ee-lco/BenchBudEE/BenchBudEE.kicad_pcb

## KiCad design BenchBudEE.kicad_pcb (2014-04-20)

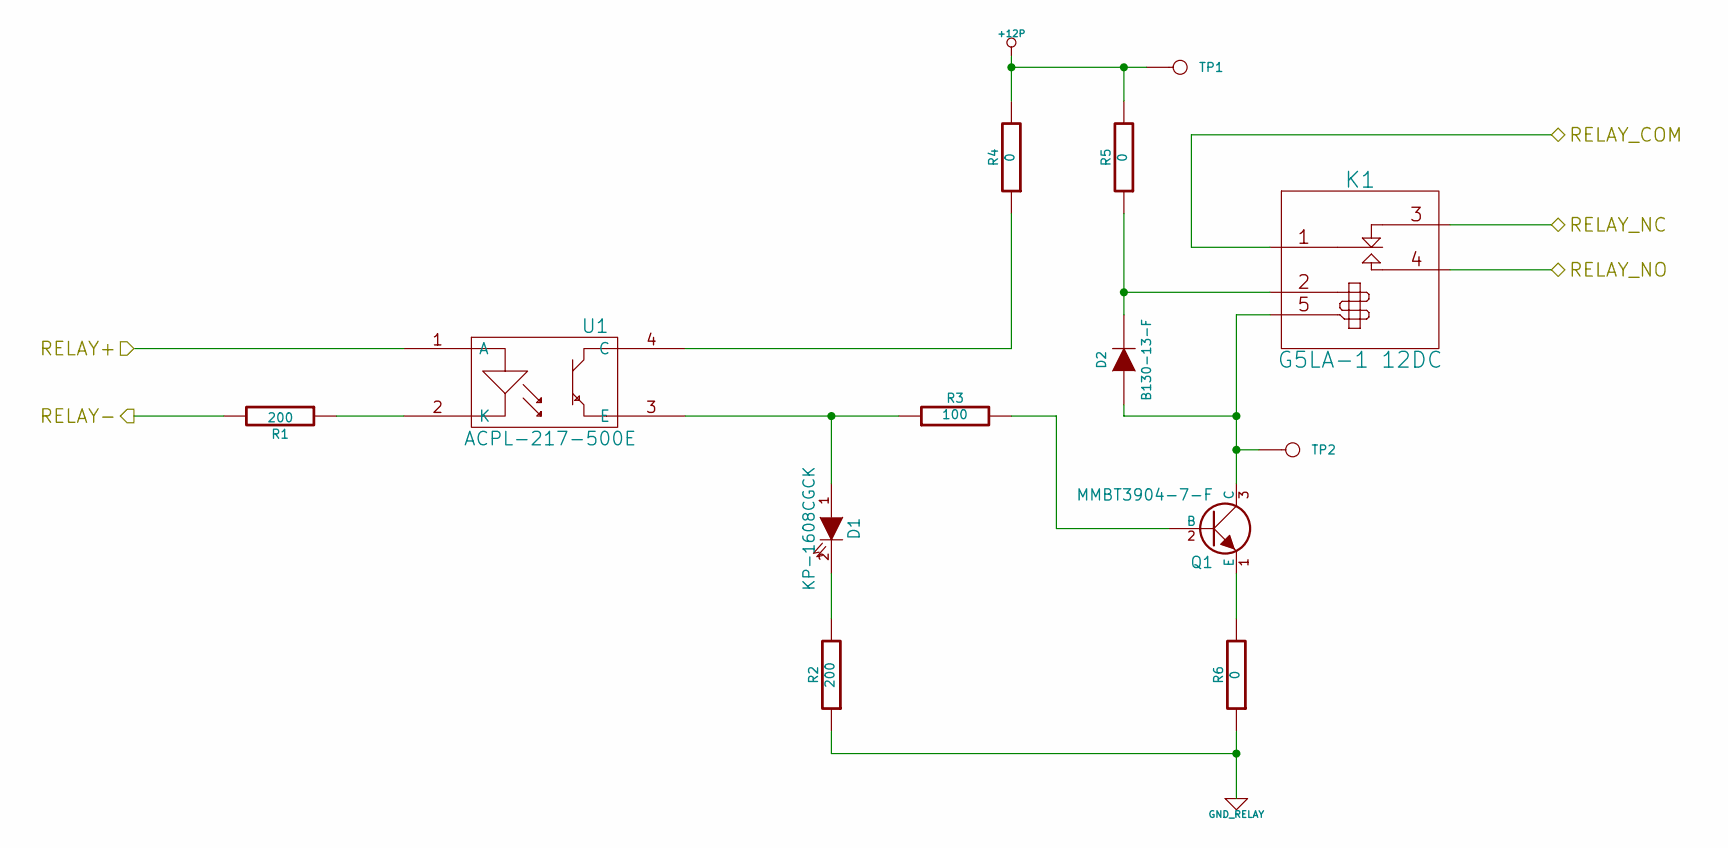
[picture p1: schematic Relay.sch]

Parts:
D1: KP-1608CGCK; LED-0603
D2: B130-13-F; Diode-SMA_Standard
K1: G5LA-1 12DC; TE-SPDT
Q1: MMBT3904-7-F; SOT23EBC; MFG Part Number MMBT3904-7-F
R1, R2: 200; SM0805
R3: 100; SM0805
R4, R5, R6: 0; SM0805
TP1: +12P; TestPointTH
TP2: RLY_LOW; TestPointTH
U1: ACPL-217-500E; 4-SMD; MFG Part Number LTV-816S

Connections:
+12P: R4.2, R5.2, TP1.1; also elsewhere on the board
/Arduino/RELAY+: U1.1 (A); also elsewhere on the board
/Arduino/RELAY-: R1.2; also elsewhere on the board
/Relay/RELAY_COM: K1.1 (COM); also elsewhere on the board
/Relay/RELAY_NC: K1.3 (NC); also elsewhere on the board
/Relay/RELAY_NO: K1.4 (NO); also elsewhere on the board
GND_RELAY: R2.1, R6.1; also elsewhere on the board
unnamed: D1.1 (A), R3.1, U1.3 (E)
unnamed: D1.2 (K), R2.2
unnamed: D2.1 (A), K1.5 (COIL-), Q1.3 (C), TP2.1
unnamed: D2.2 (K), K1.2 (COIL+), R5.1
unnamed: Q1.1 (E), R6.2
unnamed: Q1.2 (B), R3.2
unnamed: R1.1, U1.2 (K)
unnamed: R4.1, U1.4 (C)

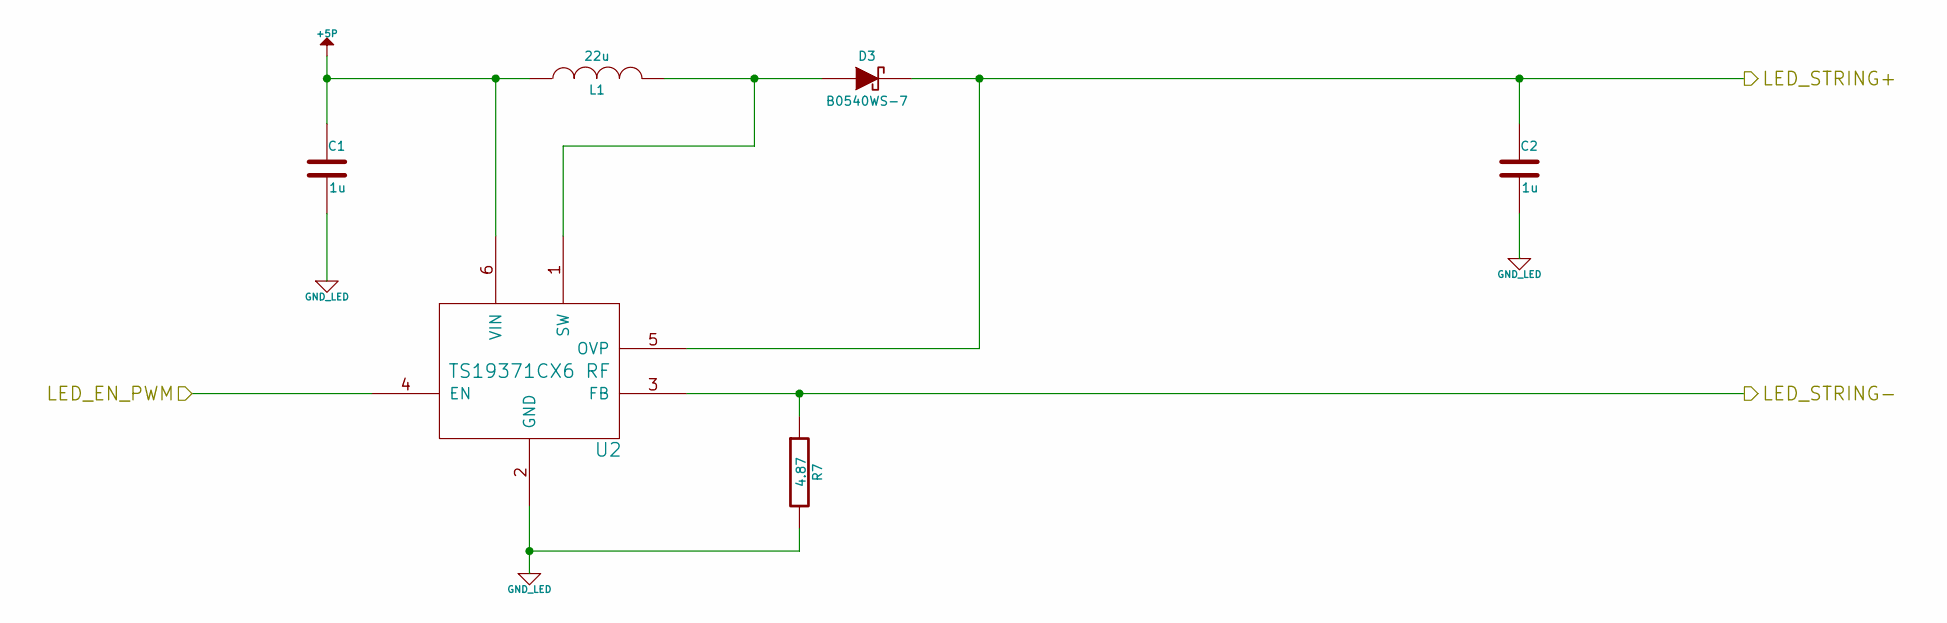
[picture p2: schematic LED_Driver.sch]

Parts:
C1, C2: 1u; c_0805
D3: B0540WS-7; SOD-323; MFG Part Number BO540WS-7
L1: 22u; NR4012; MFG Part Number NR4012T220M
R7: 4.87; SM0805
U2: TS19371CX6 RF; SOT23_6

Connections:
+5P: C1.1, L1.1, U2.6 (VIN); also elsewhere on the board
/Arduino/LED_EN_PWM: U2.4 (EN); also elsewhere on the board
/LED_Driver/LED_STRING+: C2.1, D3.2 (K), U2.5 (OVP); also elsewhere on the board
/LED_Driver/LED_STRING-: R7.1, U2.3 (FB); also elsewhere on the board
GND_LED: C1.2, C2.2, R7.2, U2.2 (GND); also elsewhere on the board
unnamed: D3.1 (A), L1.2, U2.1 (SW)

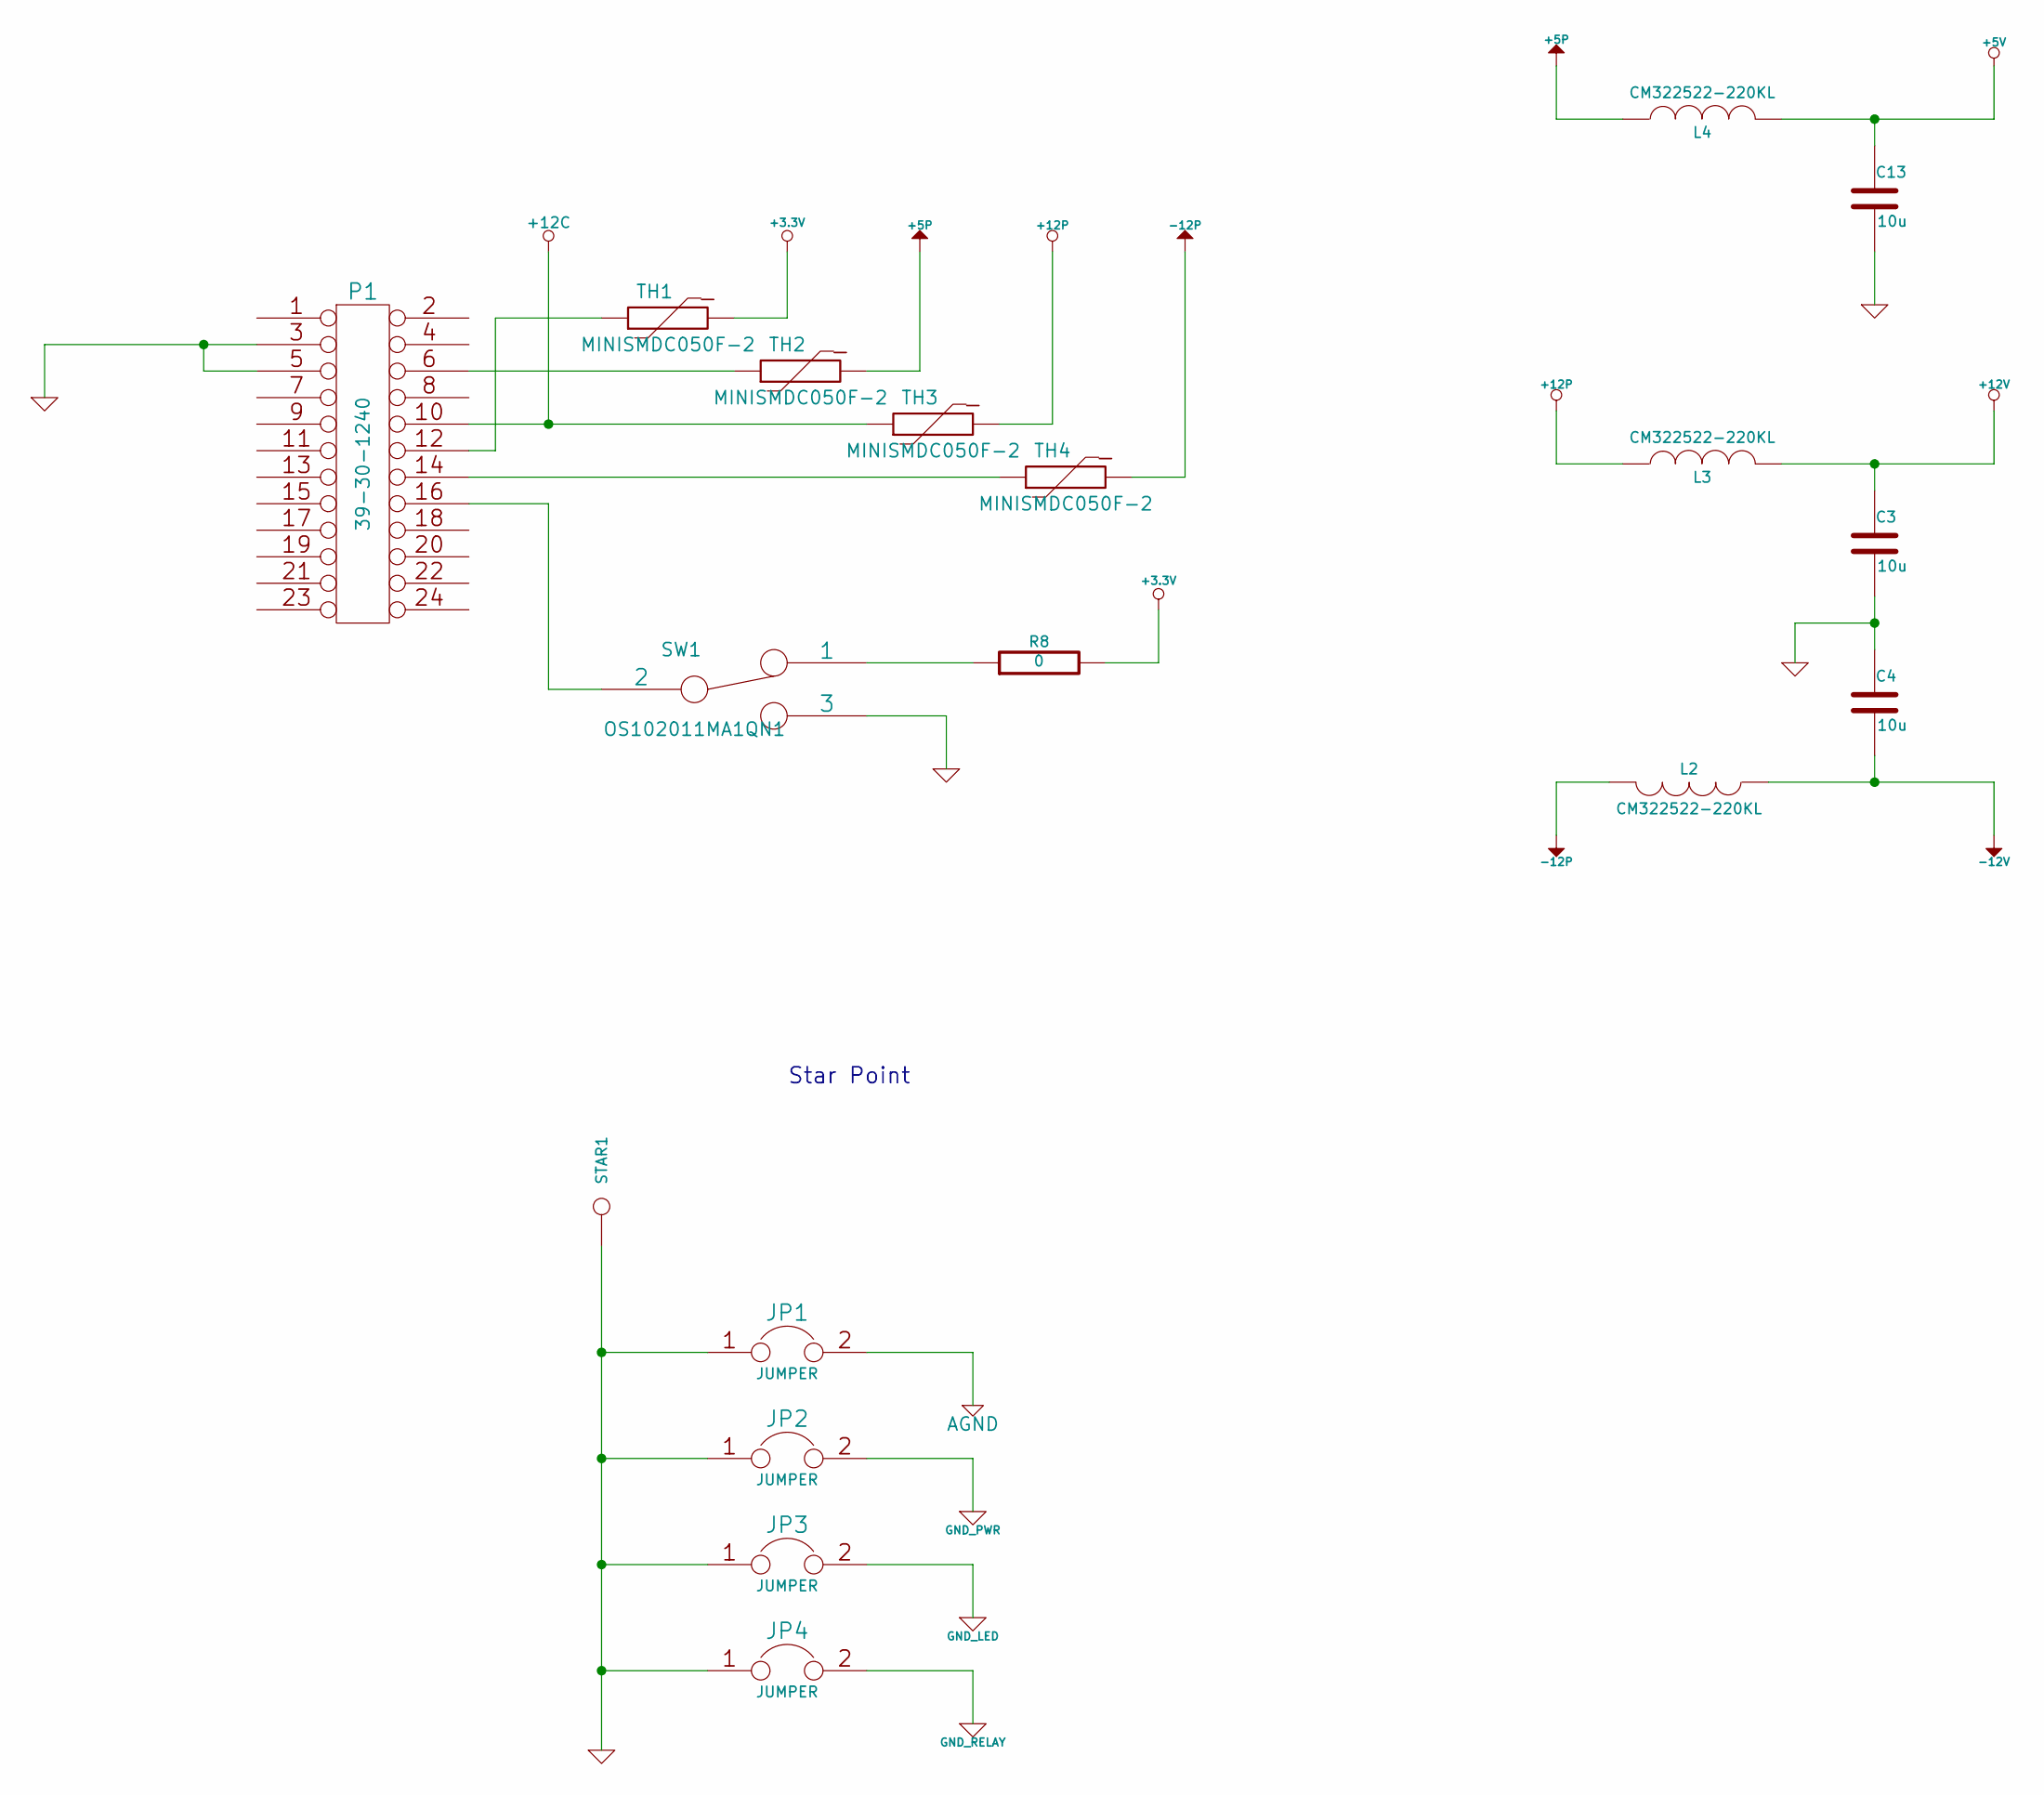
[picture p3: schematic Power.sch]

Parts:
C3, C4, C13: 10u; c_1206
JP1, JP2, JP3, JP4: JUMPER; GND_POINT
L2, L3, L4: CM322522-220KL; SM1210L
P1: 39-30-1240; ATX_Header; MFG Part Number 39-30-1240
R8: 0; SM0805
STAR1: CONN_1; 1pin
SW1: OS102011MA1QN1; BB_switch; MFG Part Number OS102011MA1QN1
TH1, TH2, TH3, TH4: MINISMDC050F-2; SM1812; MFG Part Number MINISMDC050F-2

Connections:
+3.3V: R8.2, TH1.2; also elsewhere on the board
+5P: L4.1, TH2.2; also elsewhere on the board
+5V: C13.1, L4.2; also elsewhere on the board
+12C: P1.10, TH3.1; also elsewhere on the board
+12P: L3.1, TH3.2; also elsewhere on the board
+12V: C3.1, L3.2; also elsewhere on the board
-12P: L2.2, TH4.2
-12V: C4.2, L2.1; also elsewhere on the board
AGND: JP1.2; also elsewhere on the board
GND: C3.2, C4.1, C13.2, JP1.1, JP2.1, JP3.1, JP4.1, P1.3, P1.5, STAR1.1, SW1.3; also elsewhere on the board
GND_LED: JP3.2; also elsewhere on the board
GND_PWR: JP2.2; also elsewhere on the board
GND_RELAY: JP4.2; also elsewhere on the board
unnamed: P1.6, TH2.1
unnamed: P1.12, TH1.1
unnamed: P1.14, TH4.1
unnamed: P1.16, SW1.2
unnamed: R8.1, SW1.1

Notes on the sheet:
Star Point

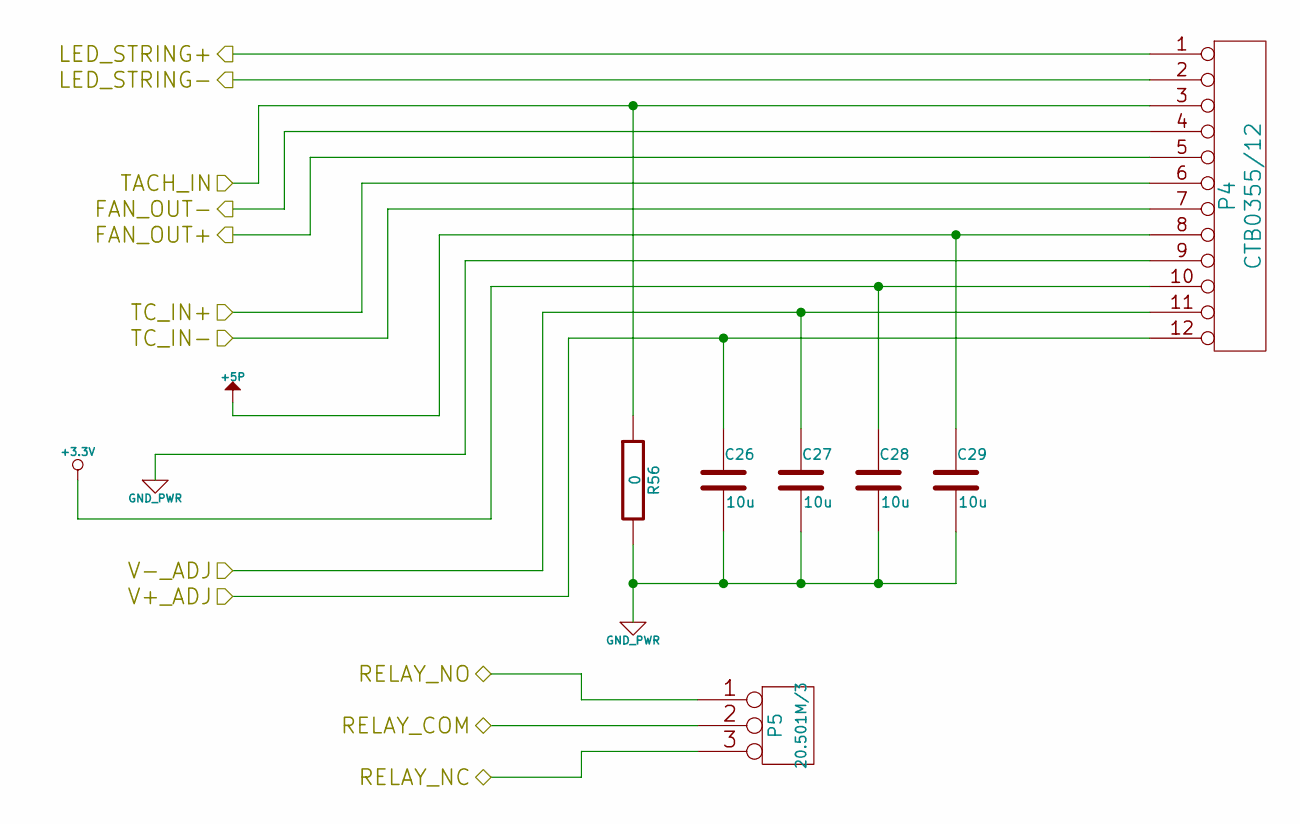
[picture p4: schematic TerminalBlock.sch]

Parts:
C26, C27, C28, C29: 10u; c_1210
P4: CTB0355/12; 12pinTB; MFG Part Number OSTTE120104
P5: 20.501M/3; 3pinTB; MFG Part Number 1935174
R56: 0; SM0805

Connections:
+3.3V: C28.1, P4.10; also elsewhere on the board
+5P: C29.1, P4.8; also elsewhere on the board
/Fan/FAN_OUT+: P4.5; also elsewhere on the board
/Fan/FAN_OUT-: P4.4; also elsewhere on the board
/Fan/TACH_IN: P4.3, R56.1; also elsewhere on the board
/LED_Driver/LED_STRING+: P4.1; also elsewhere on the board
/LED_Driver/LED_STRING-: P4.2; also elsewhere on the board
/PowerAdjustmentMonitor/V+_ADJ: C26.1, P4.12; also elsewhere on the board
/PowerAdjustmentMonitor/V-_ADJ: C27.1, P4.11; also elsewhere on the board
/Relay/RELAY_COM: P5.2 (PM); also elsewhere on the board
/Relay/RELAY_NC: P5.3; also elsewhere on the board
/Relay/RELAY_NO: P5.1; also elsewhere on the board
/TerminalBlock/TC_IN+: P4.6; also elsewhere on the board
/TerminalBlock/TC_IN-: P4.7; also elsewhere on the board
GND_PWR: C26.2, C27.2, C28.2, C29.2, P4.9, R56.2; also elsewhere on the board

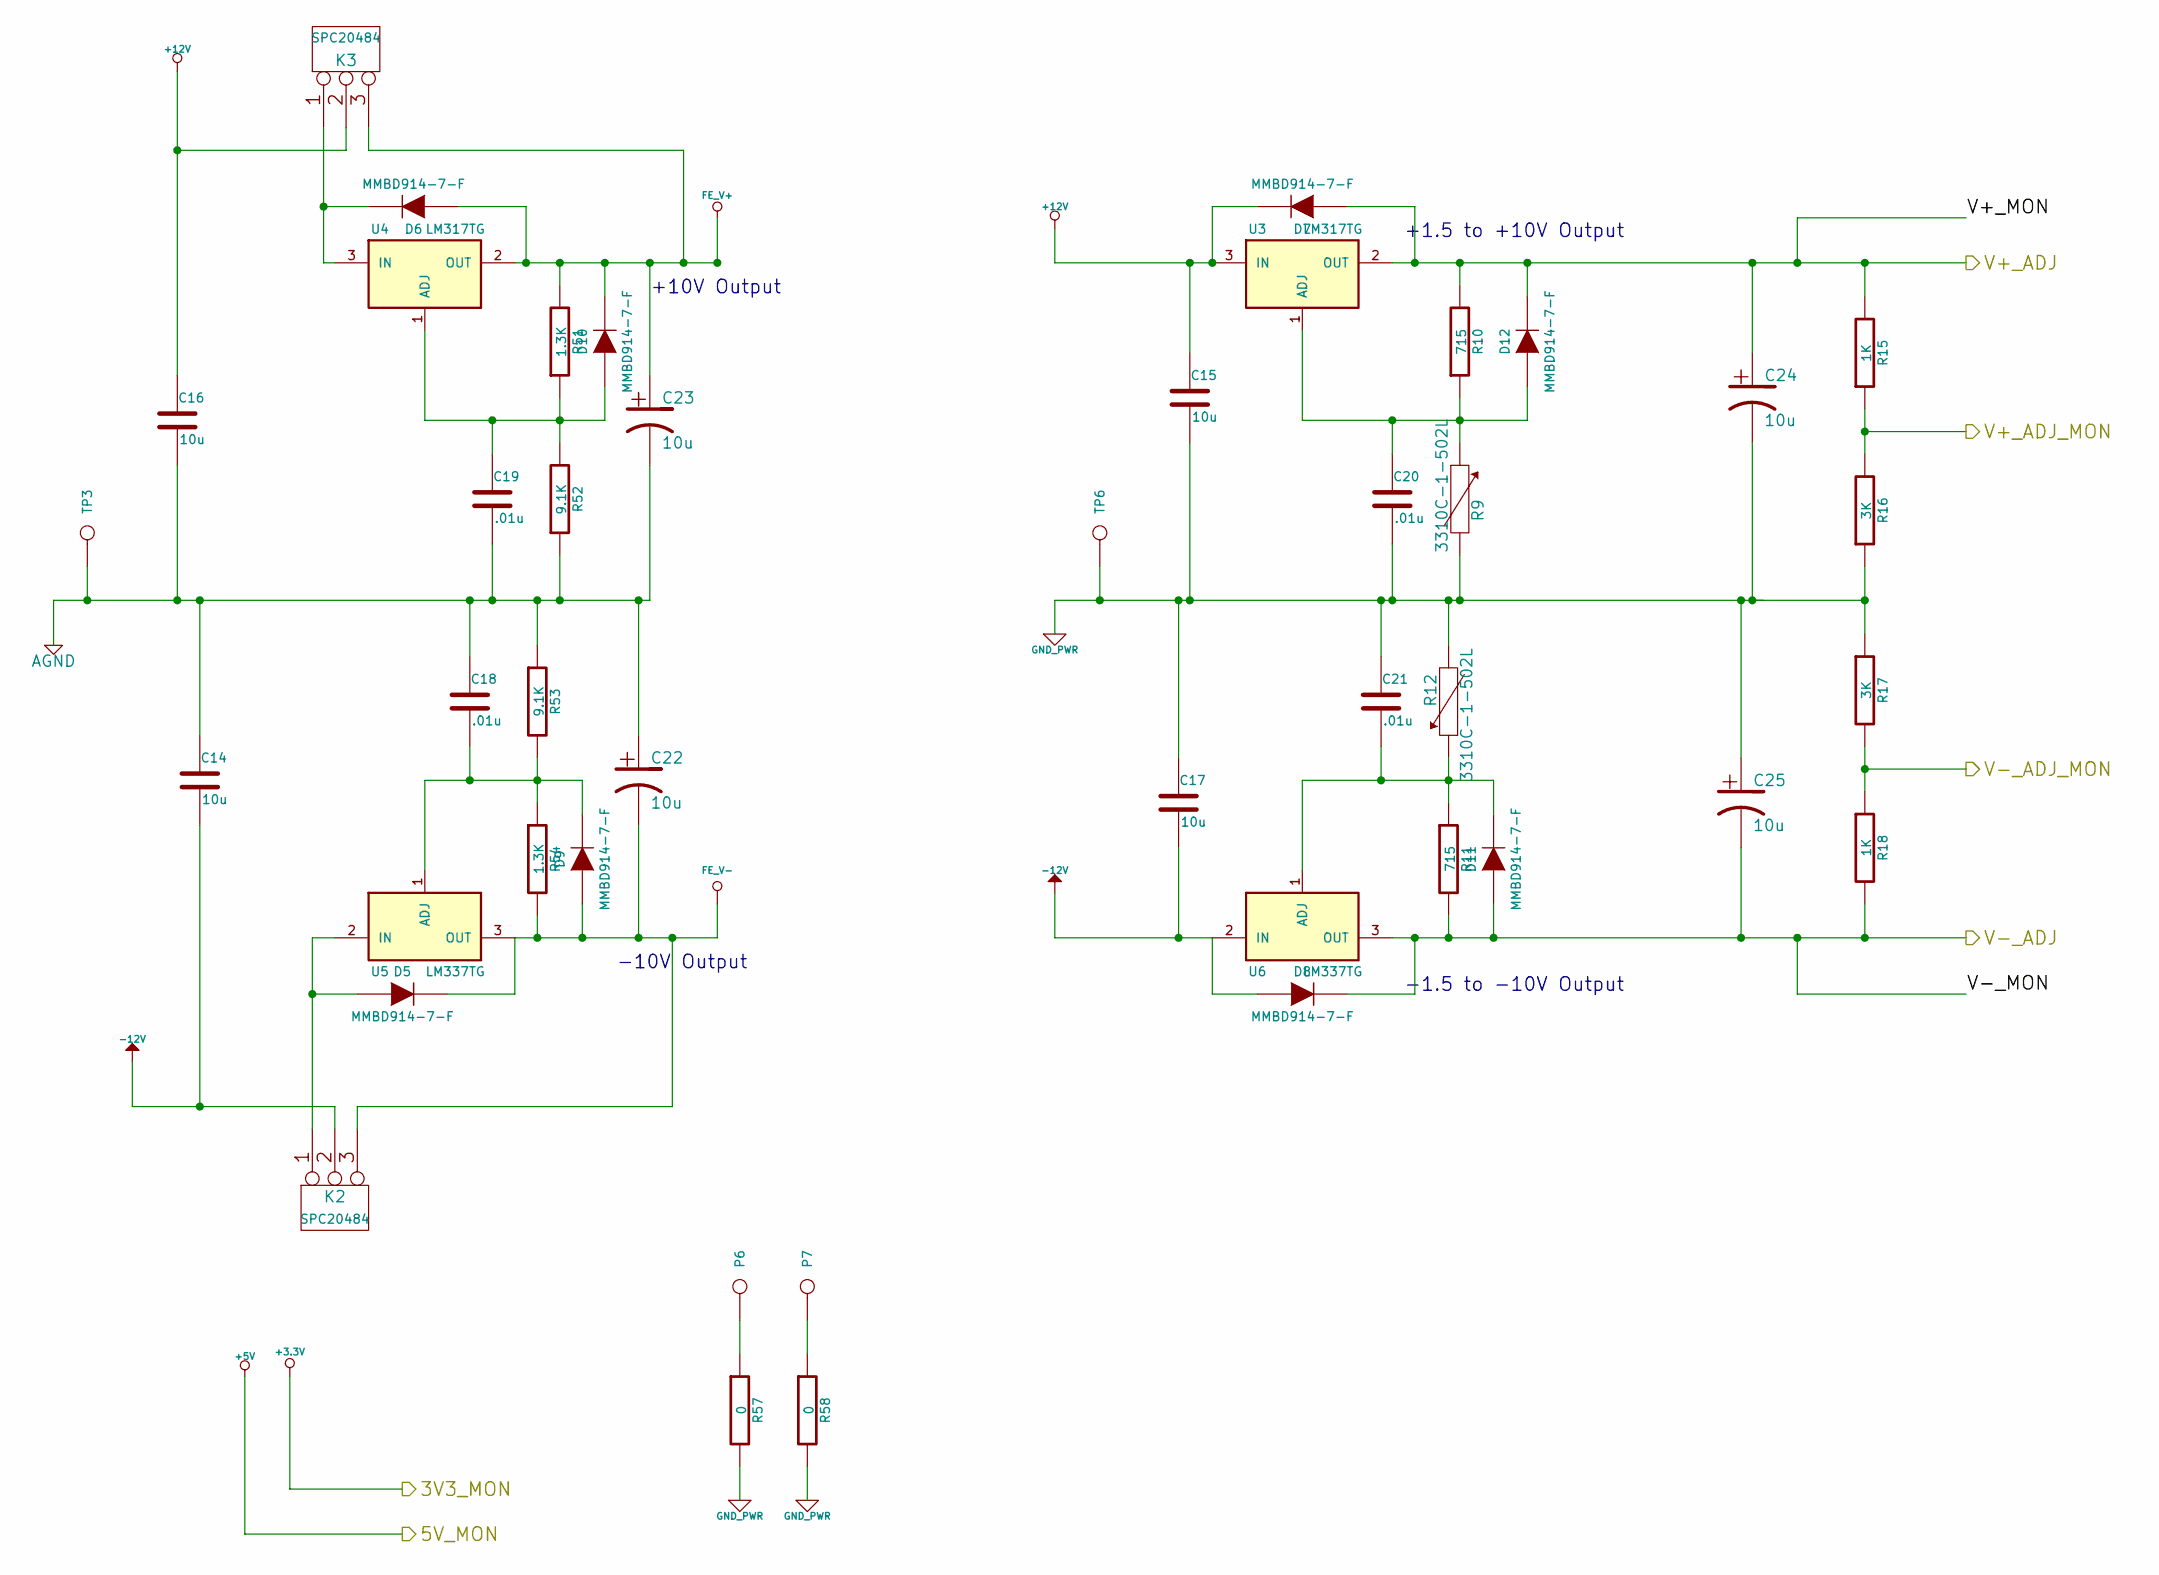
[picture p5: schematic PowerAdjustmentMonitor.sch]

Parts:
C14, C15, C16, C17, C22, C23, C24, C25: 10u; c_0805
C18, C19, C20, C21: .01u; c_0805
D5, D6, D7, D8, D9, D10, D11, D12: MMBD914-7-F; SOT23-DIODE; MFG Part Number MMBD914-7-F
K2, K3: SPC20484; Pin_Header_Straight_1x03
P6, P7: MC33282; V8508H
R9, R12: 3310C-1-502L; EVUE3K
R10, R11: 715; SM0805
R15, R18: 1K; SM0805
R16, R17: 3K; SM0805
R51, R54: 1.3K; SM0805
R52, R53: 9.1K; SM0805
R57, R58: 0; SM0805
TP3: AGND; TestPointTH
TP6: GND_PWR; TestPointTH
U3, U4: LM317TG; TO-220_Neutral123_Vertical
U5, U6: LM337TG; TO-220_Neutral123_Vertical

Connections:
+12V: C15.1, C16.1, D7.2 (K), K3.2 (PM), U3.3 (IN); also elsewhere on the board
-12V: C14.2, C17.2, D8.1 (A), K2.2 (PM), U6.2 (IN); also elsewhere on the board
/Arduino/V+_ADJ_MON: R15.1, R16.2; also elsewhere on the board
/Arduino/V-_ADJ_MON: R17.2, R18.1; also elsewhere on the board
/PowerAdjustmentMonitor/V+_ADJ: C24.1, D7.1 (A), D12.2 (K), R10.2, R15.2, U3.2 (OUT); also elsewhere on the board
/PowerAdjustmentMonitor/V-_ADJ: C25.2, D8.2 (K), D11.1 (A), R11.2, R18.2, U6.3 (OUT); also elsewhere on the board
AGND: C14.1, C16.2, C18.1, C19.2, C22.1, C23.2, R52.1, R53.1, TP3.1; also elsewhere on the board
FE_V+: C23.1, D6.1 (A), D10.2 (K), K3.3, R51.2, U4.2 (OUT); also elsewhere on the board
FE_V-: C22.2, D5.2 (K), D9.1 (A), K2.3, R54.2, U5.3 (OUT); also elsewhere on the board
GND_PWR: C15.2, C17.1, C20.2, C21.1, C24.2, C25.1, R9.2, R12.2, R16.1, R17.1, R57.2, R58.2, TP6.1; also elsewhere on the board
unnamed: C18.2, D9.2 (K), R53.2, R54.1, U5.1 (ADJ)
unnamed: C19.1, D10.1 (A), R51.1, R52.2, U4.1 (ADJ)
unnamed: C20.1, D12.1 (A), R9.1, R10.1, U3.1 (ADJ)
unnamed: C21.2, D11.2 (K), R11.1, R12.1, U6.1 (ADJ)
unnamed: D5.1 (A), K2.1, U5.2 (IN)
unnamed: D6.2 (K), K3.1, U4.3 (IN)
unnamed: P6.1, R57.1
unnamed: P7.1, R58.1

Notes on the sheet:
+10V Output
+1.5 to +10V Output
-1.5 to -10V Output
-10V Output

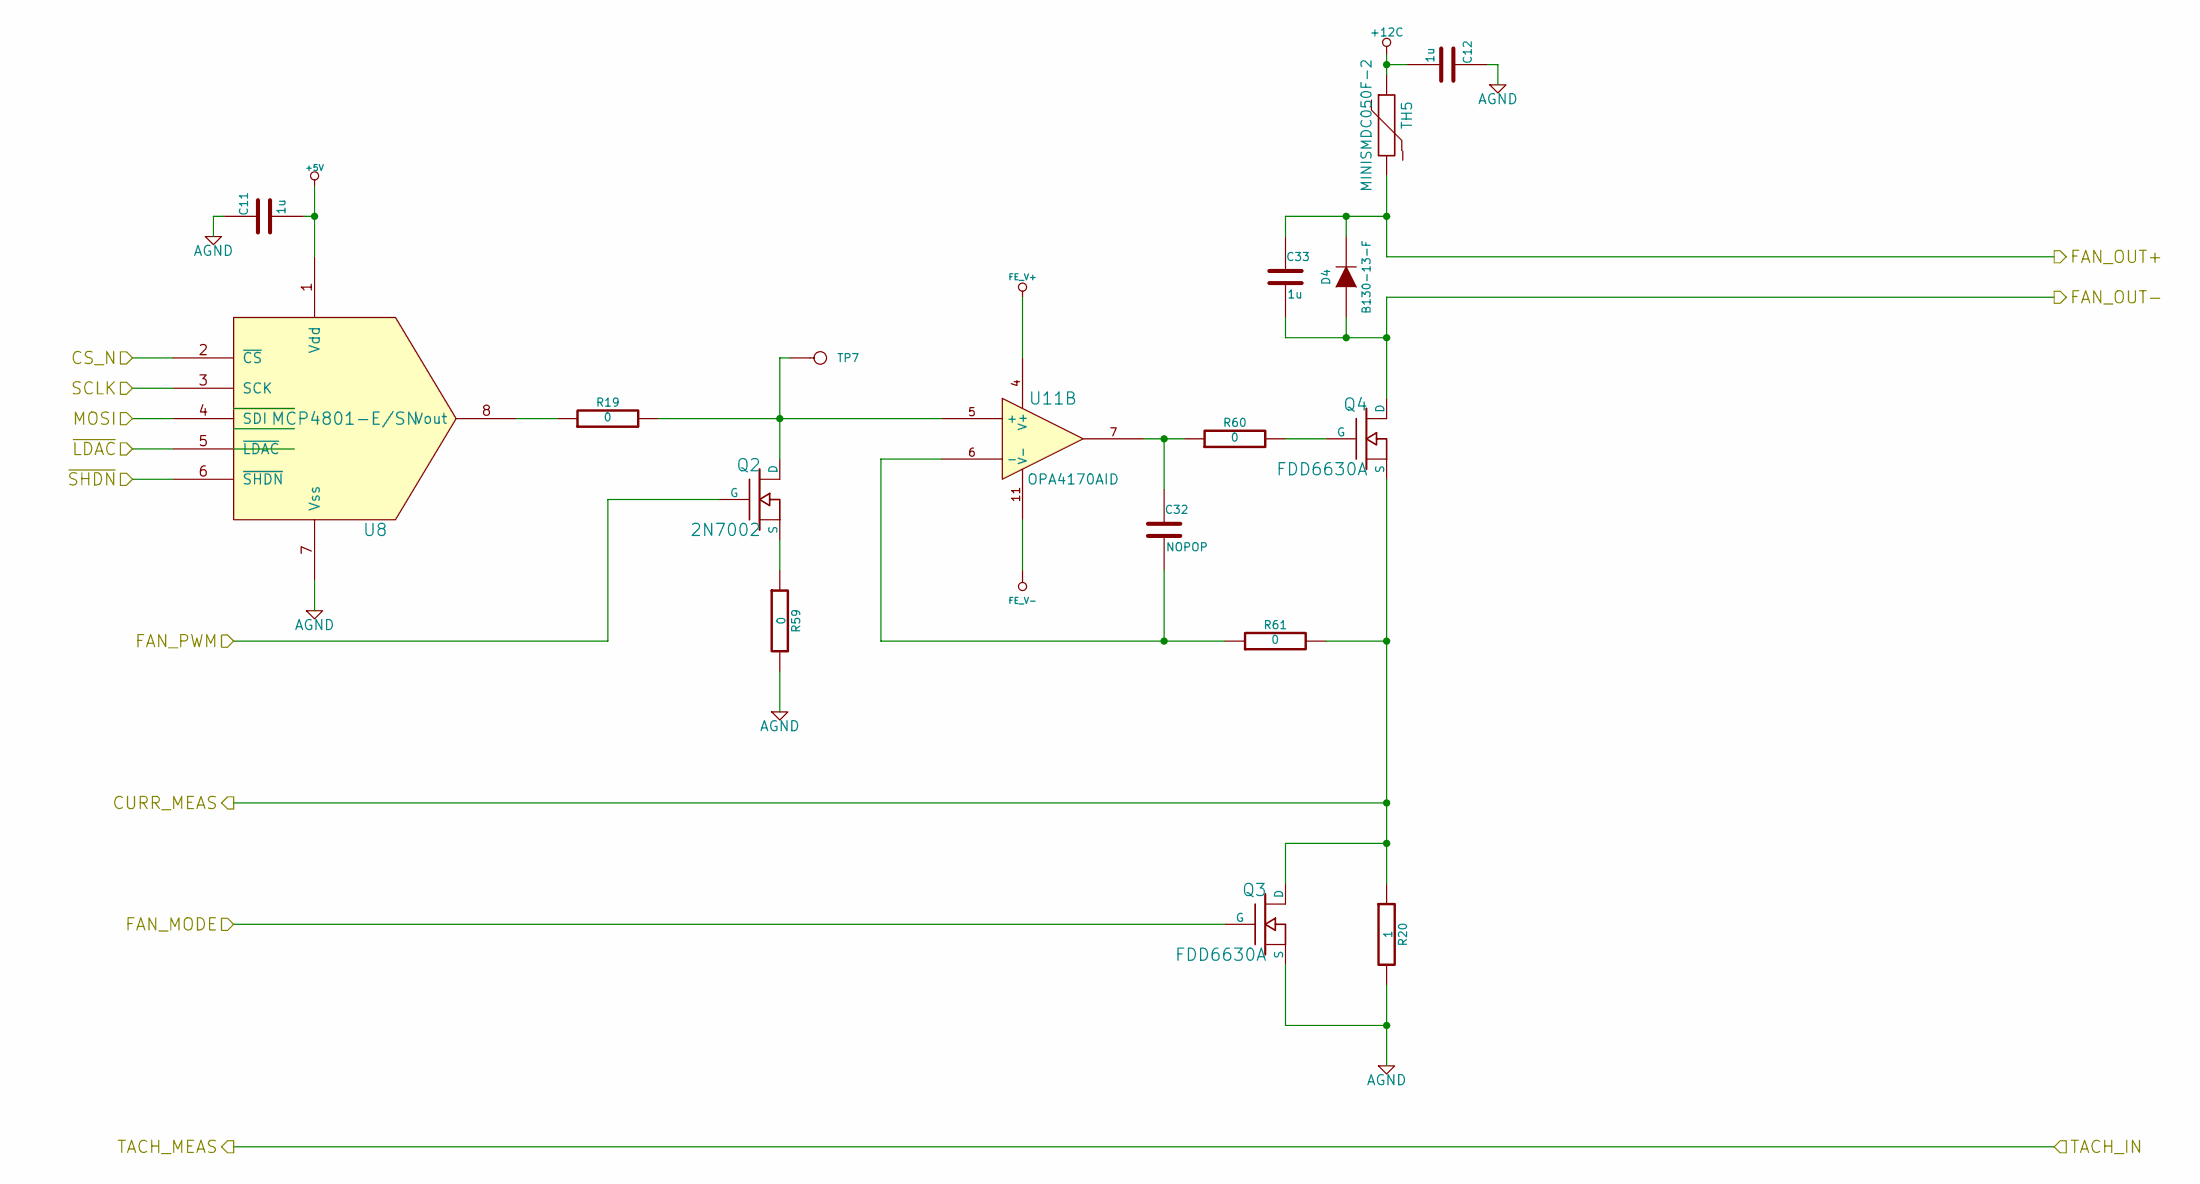
[picture p6: schematic Fan.sch]

Parts:
C11, C12, C33: 1u; c_0805
C32: NOPOP; c_0805
D4: B130-13-F; Diode-SMA_Standard; MFG Part Number B130-13-F
Q2: 2N7002; SOT23EBC; MFG Part Number DMN65D8L-7
Q3, Q4: FDD6630A; DPAK2; MFG Part Number AOD476
R19, R59, R60, R61: 0; SM0805
R20: 1; SM1206
TH5: MINISMDC050F-2; SM1812; MFG Part Number MINISMDC050F-2
TP7: DAC_OUT; TestPointTH
U8: MCP4801-E/SN; SO8N
U11: OPA4170AID; SO14E

Connections:
+5V: C11.2, U8.1 (Vdd); also elsewhere on the board
+12C: C12.2, TH5.1; also elsewhere on the board
/Arduino/CURR_MEAS: Q3.2 (D), Q4.3 (S), R20.1, R61.2; also elsewhere on the board
/Arduino/FAN_MODE: Q3.1 (G); also elsewhere on the board
/Arduino/FAN_PWM: Q2.1 (G); also elsewhere on the board
/Arduino/MOSI: U8.4 (SDI); also elsewhere on the board
/Arduino/SCLK: U8.3 (SCK); also elsewhere on the board
/Arduino/~LDAC: U8.5 (~LDAC); also elsewhere on the board
/Arduino/~SHDN: U8.6 (~SHDN); also elsewhere on the board
/Fan/CS_N: U8.2 (~CS); also elsewhere on the board
/Fan/FAN_OUT+: C33.1, D4.2 (K), TH5.2; also elsewhere on the board
/Fan/FAN_OUT-: C33.2, D4.1 (A), Q4.2 (D); also elsewhere on the board
AGND: C11.1, C12.1, Q3.3 (S), R20.2, R59.2, U8.7 (Vss); also elsewhere on the board
FE_V+: U11.4 (V+); also elsewhere on the board
FE_V-: U11.11 (V-); also elsewhere on the board
unnamed: C32.1, R60.1, U11.7
unnamed: C32.2, R61.1, U11.6 (-)
unnamed: Q2.2 (D), R19.2, TP7.1, U11.5 (+)
unnamed: Q2.3 (S), R59.1
unnamed: Q4.1 (G), R60.2
unnamed: R19.1, U8.8 (Vout)

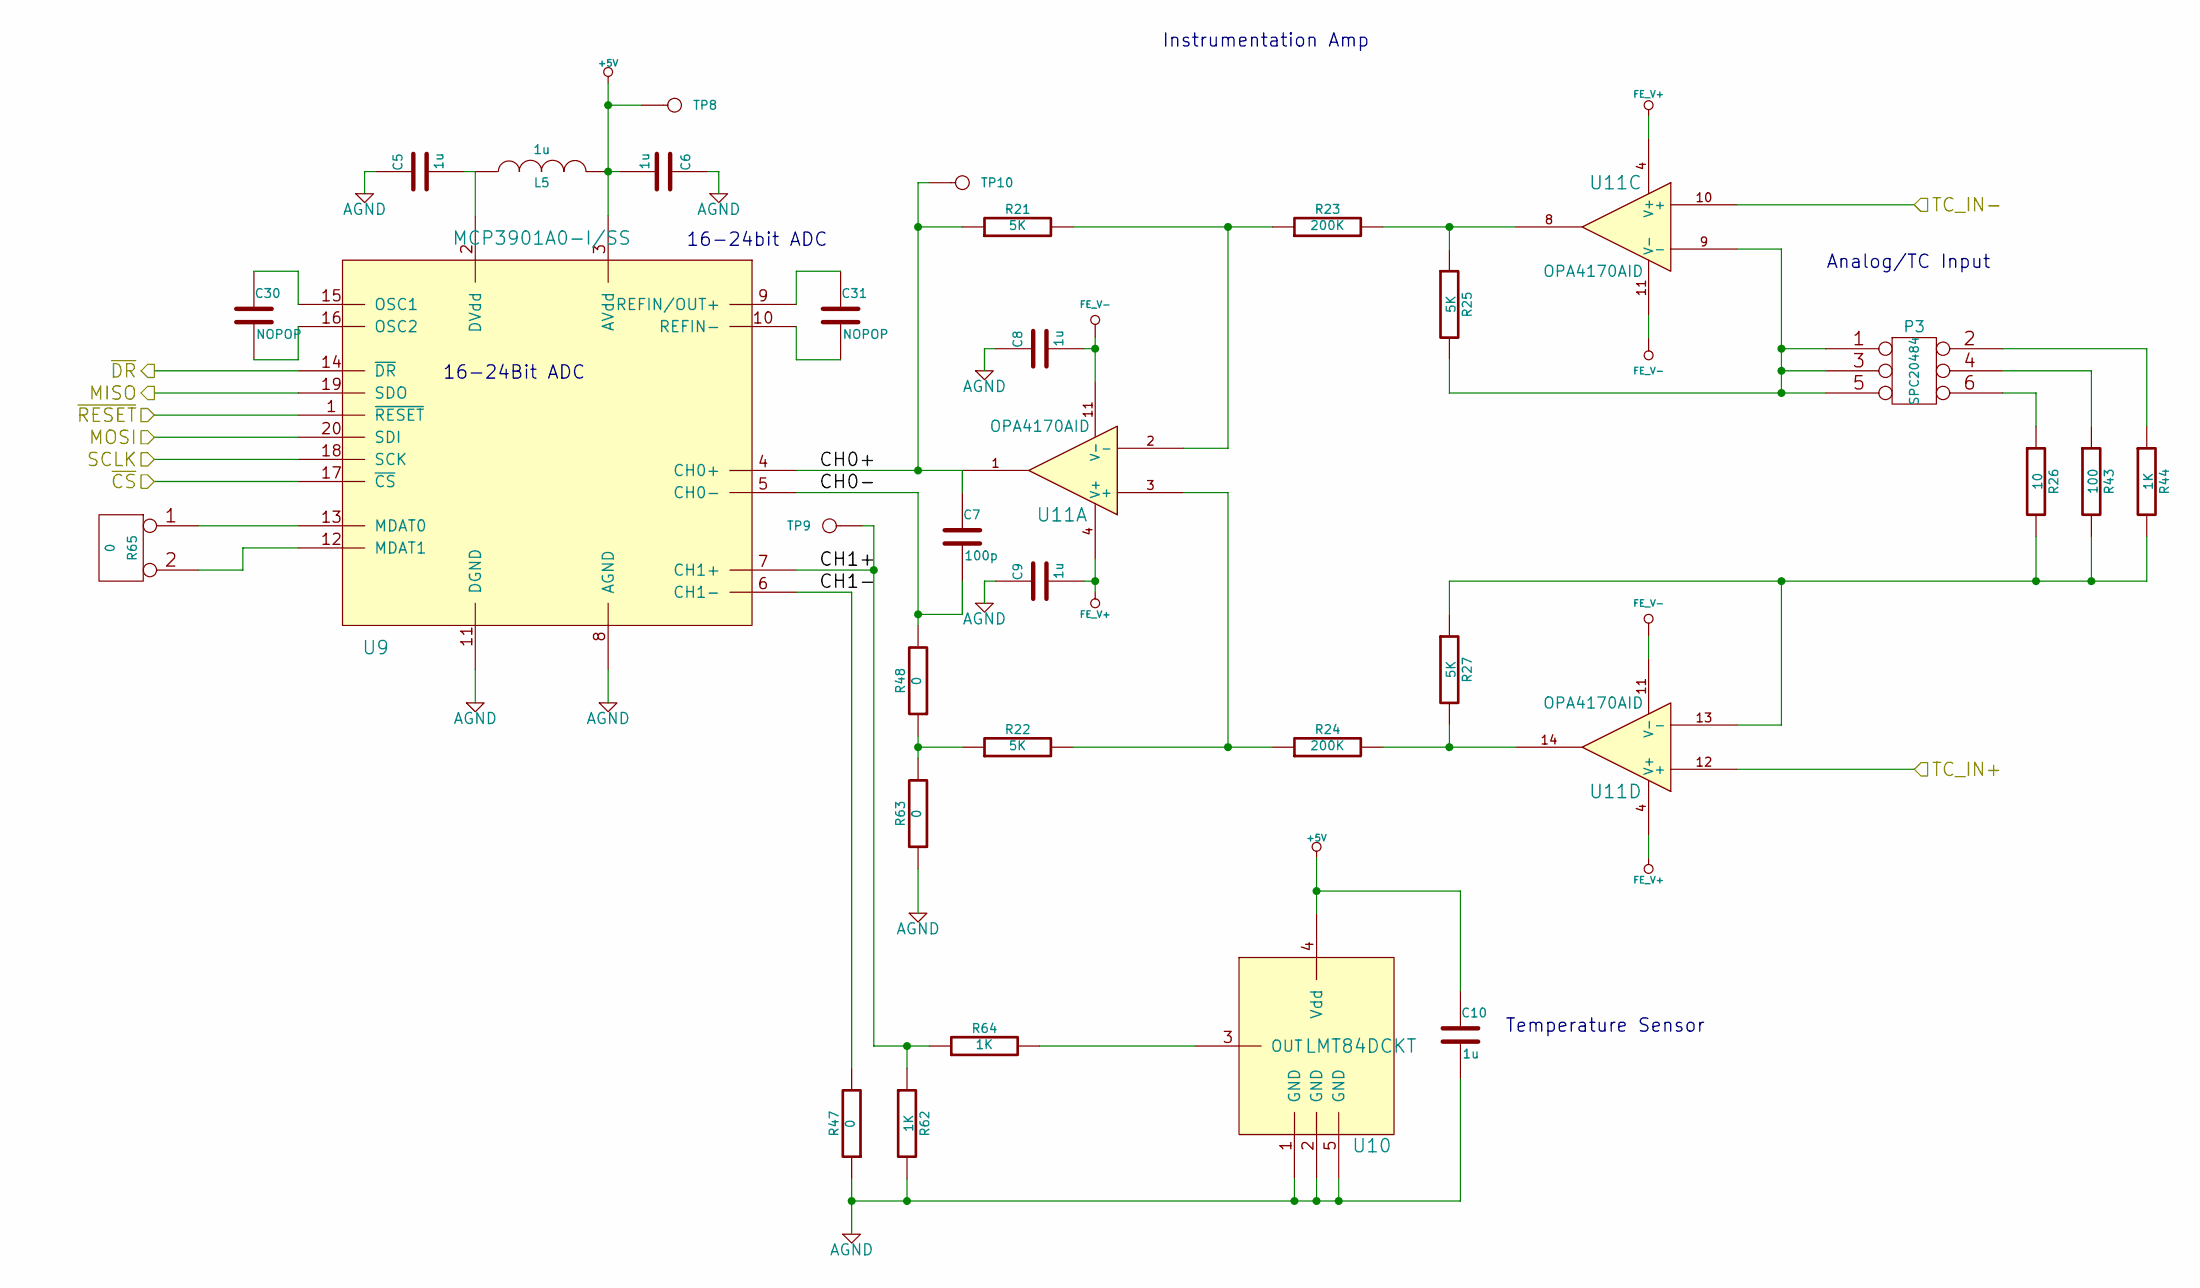
[picture p7: schematic Thermocouple.sch]

Parts:
C5, C6, C8, C9, C10: 1u; c_0805
C7: 100p; c_0805
C30, C31: NOPOP; c_0805
L5: 1u; SM0805
P3: SPC20484; Pin_Header_Straight_2x03
R21, R22: 5K; SM1206
R23, R24: 200K; SM1206
R25, R27: 5K; SM0805
R26: 10; SM0805
R43: 100; SM0805
R44, R62, R64: 1K; SM0805
R47, R48, R63, R65: 0; SM0805
TP8: +5V; TestPointTH
TP9: CH1+; TestPointTH
TP10: CH0+; TestPointTH
U9: MCP3901A0-I/SS; SSOP20
U10: LMT84DCKT; SOT353
U11: OPA4170AID; SO14E

Connections:
+5V: C6.2, C10.1, L5.2, TP8.1, U9.3 (AVdd), U10.4 (Vdd); also elsewhere on the board
/Arduino/MISO: U9.19 (SDO); also elsewhere on the board
/Arduino/MOSI: U9.20 (SDI); also elsewhere on the board
/Arduino/SCLK: U9.18 (SCK); also elsewhere on the board
/Arduino/~ADC_CS: U9.17 (~CS); also elsewhere on the board
/Arduino/~DR: U9.14 (~DR); also elsewhere on the board
/Arduino/~RESET: U9.1 (~RESET); also elsewhere on the board
/TerminalBlock/TC_IN+: U11.12 (+); also elsewhere on the board
/TerminalBlock/TC_IN-: U11.10 (+); also elsewhere on the board
/Thermocouple/CH0+: C7.1, R21.1, TP10.1, U9.4 (CH0+), U11.1
/Thermocouple/CH0-: C7.2, R48.2, U9.5 (CH0-)
/Thermocouple/CH1+: R62.1, R64.1, TP9.1, U9.7 (CH1+)
/Thermocouple/CH1-: R47.2, U9.6 (CH1-)
AGND: C5.1, C6.1, C8.1, C9.1, C10.2, R47.1, R62.2, R63.1, U9.8 (AGND), U9.11 (DGND), U10.1 (GND), U10.2 (GND), U10.5 (GND); also elsewhere on the board
FE_V+: C9.2, U11.4 (V+); also elsewhere on the board
FE_V-: C8.2, U11.11 (V-); also elsewhere on the board
unnamed: C5.2, L5.1, U9.2 (DVdd)
unnamed: C30.1, U9.15 (OSC1)
unnamed: C30.2, U9.16 (OSC2)
unnamed: C31.1, U9.9 (REFIN/OUT+)
unnamed: C31.2, U9.10 (REFIN-)
unnamed: P3.1, P3.3, P3.5, R25.2, U11.9 (-)
unnamed: P3.2, R44.1
unnamed: P3.4, R43.1
unnamed: P3.6, R26.1
unnamed: R21.2, R23.1, U11.2 (-)
unnamed: R22.1, R48.1, R63.2
unnamed: R22.2, R24.1, U11.3 (+)
unnamed: R23.2, R25.1, U11.8
unnamed: R24.2, R27.2, U11.14
unnamed: R26.2, R27.1, R43.2, R44.2, U11.13 (-)
unnamed: R64.2, U10.3 (OUT)
unnamed: R65.1, U9.13 (MDAT0)
unnamed: R65.2 (PM), U9.12 (MDAT1)

Notes on the sheet:
Analog/TC Input
Instrumentation Amp
16-24Bit ADC
Temperature Sensor
16-24bit ADC
