ee-lco/BenchBudEE/BenchBudEE.kicad_pcb

## KiCad design BenchBudEE.kicad_pcb (continued)

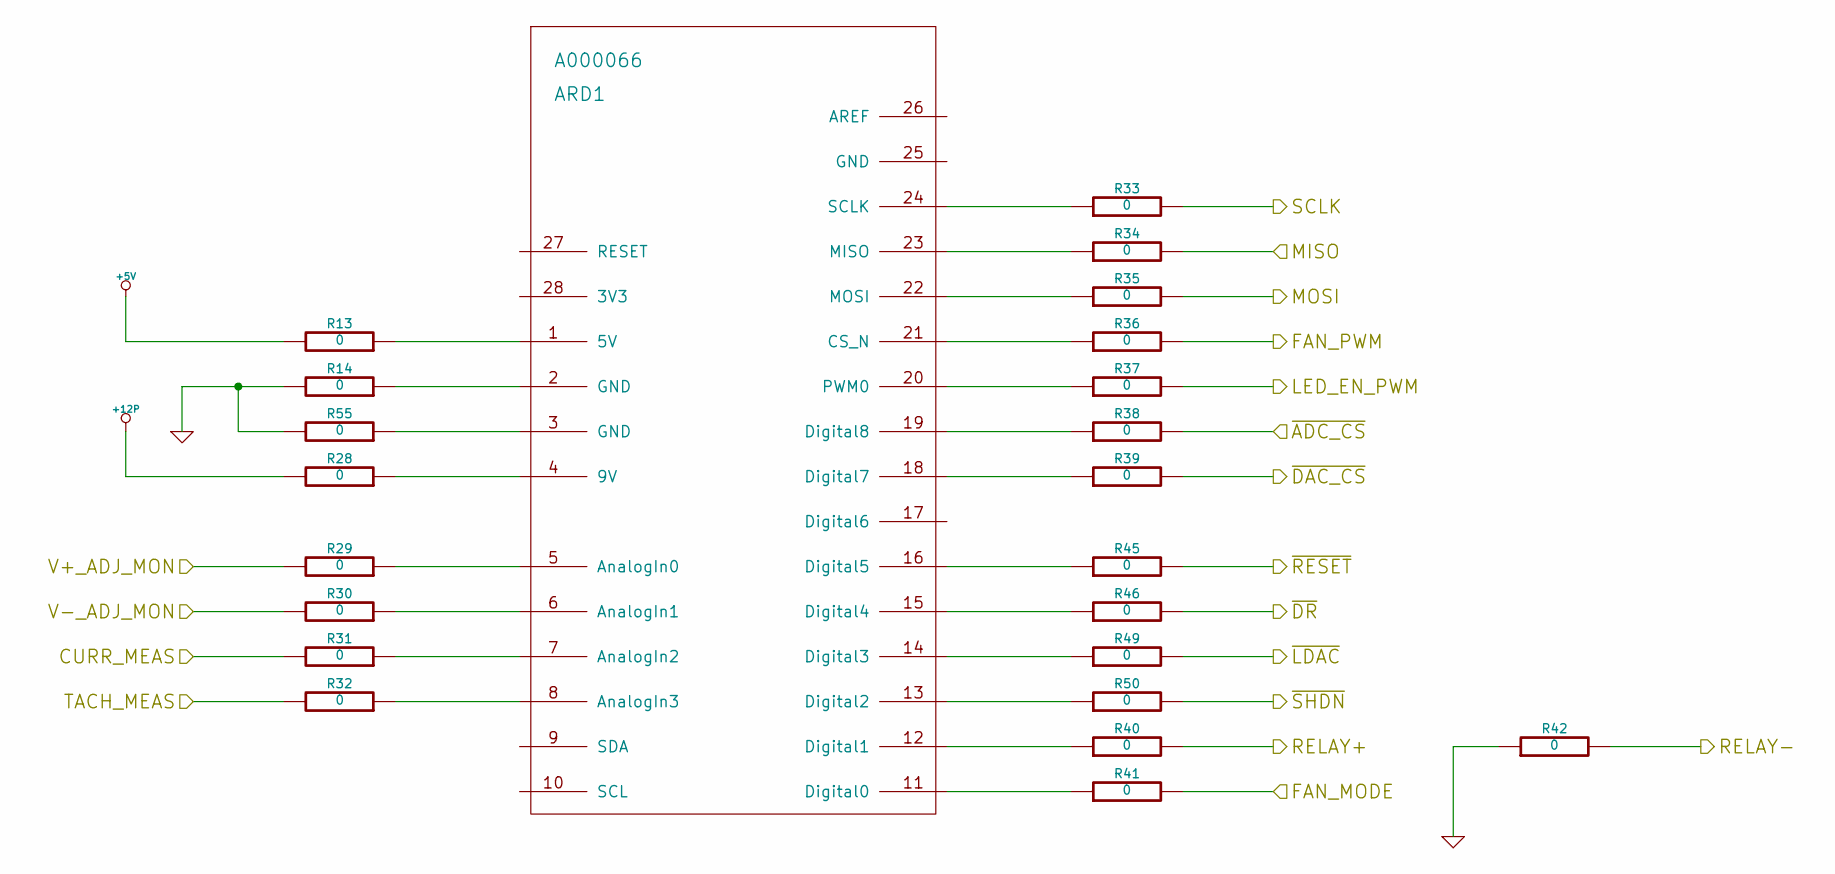
[picture p8: schematic Arduino.sch]

Parts:
ARD1: A000066; Arduino
R13, R14, R28, R29, R30, R31, R32, R33, R34, R35, R36, R37, R38, R39, R40, R41, R42, R45, R46, R49, R50, R55: 0; Resistor_SMD0805_Blob

Connections:
+5V: R13.2; also elsewhere on the board
+12P: R28.2; also elsewhere on the board
/Arduino/CURR_MEAS: R31.2; also elsewhere on the board
/Arduino/FAN_MODE: R41.2; also elsewhere on the board
/Arduino/FAN_PWM: R36.2; also elsewhere on the board
/Arduino/LED_EN_PWM: R37.2; also elsewhere on the board
/Arduino/MISO: R34.2; also elsewhere on the board
/Arduino/MOSI: R35.2; also elsewhere on the board
/Arduino/RELAY+: R40.2; also elsewhere on the board
/Arduino/RELAY-: R42.2; also elsewhere on the board
/Arduino/SCLK: R33.2; also elsewhere on the board
/Arduino/V+_ADJ_MON: R29.2; also elsewhere on the board
/Arduino/V-_ADJ_MON: R30.2; also elsewhere on the board
/Arduino/~ADC_CS: R38.2; also elsewhere on the board
/Arduino/~DR: R46.2; also elsewhere on the board
/Arduino/~LDAC: R49.2; also elsewhere on the board
/Arduino/~RESET: R45.2; also elsewhere on the board
/Arduino/~SHDN: R50.2; also elsewhere on the board
/Fan/CS_N: R39.2; also elsewhere on the board
/Fan/TACH_IN: R32.2; also elsewhere on the board
GND: R14.2, R42.1, R55.2; also elsewhere on the board
unnamed: ARD1.1 (5V), R13.1
unnamed: ARD1.2 (GND), R14.1
unnamed: ARD1.3 (GND), R55.1
unnamed: ARD1.4 (9V), R28.1
unnamed: ARD1.5 (AnalogIn0), R29.1
unnamed: ARD1.6 (AnalogIn1), R30.1
unnamed: ARD1.7 (AnalogIn2), R31.1
unnamed: ARD1.8 (AnalogIn3), R32.1
unnamed: ARD1.11 (Digital0), R41.1
unnamed: ARD1.12 (Digital1), R40.1
unnamed: ARD1.13 (Digital2), R50.1
unnamed: ARD1.14 (Digital3), R49.1
unnamed: ARD1.15 (Digital4), R46.1
unnamed: ARD1.16 (Digital5), R45.1
unnamed: ARD1.18 (Digital7), R39.1
unnamed: ARD1.19 (Digital8), R38.1
unnamed: ARD1.20 (PWM0), R37.1
unnamed: ARD1.21 (CS_N), R36.1
unnamed: ARD1.22 (MOSI), R35.1
unnamed: ARD1.23 (MISO), R34.1
unnamed: ARD1.24 (SCLK), R33.1

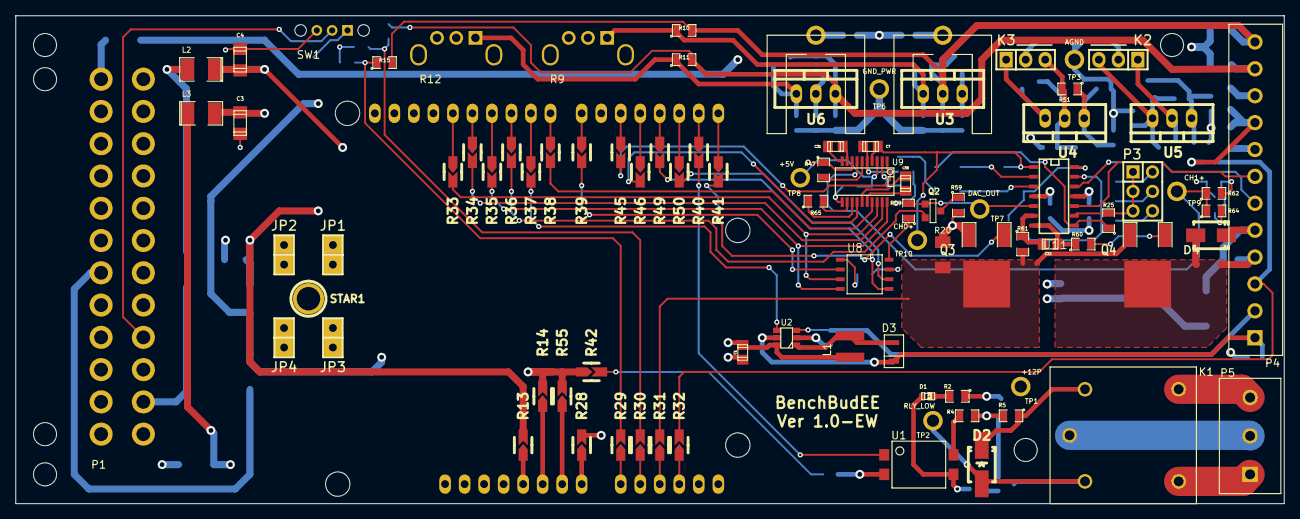
[picture p9: board BenchBudEE.kicad_pcb from above]

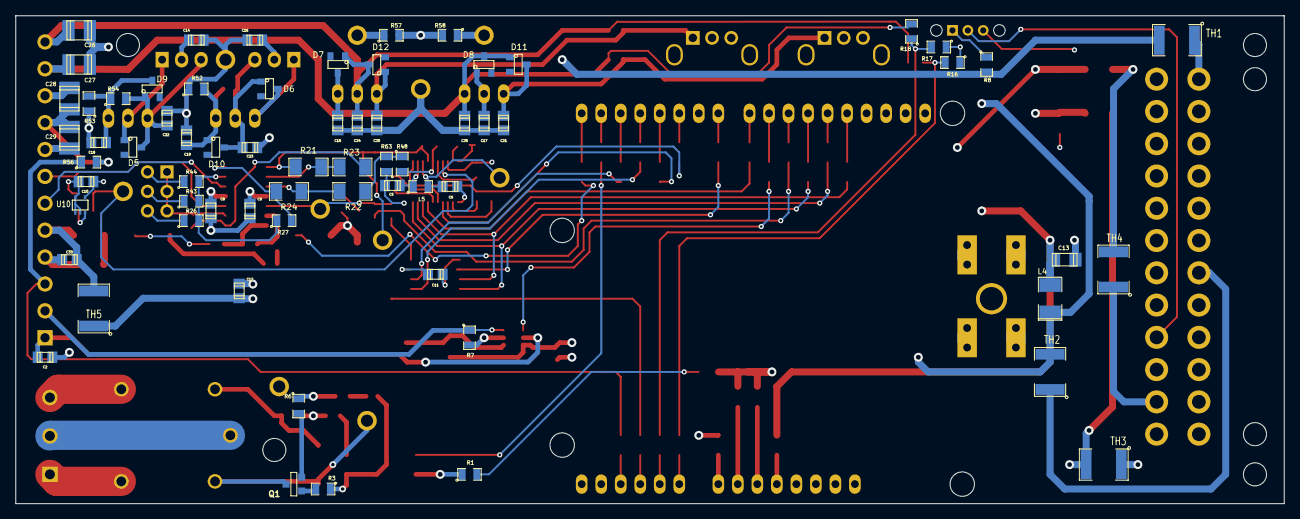
[picture p10: board BenchBudEE.kicad_pcb from below]

Board: 4 copper layers, 165.1 x 63.5 mm, 162 parts (67 on the bottom side), 115 nets.

Other parts of the board:
3 mm, 3 mm#2, 3 mm#3, 3 mm#4: VAL**; 3mm-NPTH
