ee-lco/BenchBudEE/(commit log)

2014-01-30 Created empty BenchBudEE KiCad project
    [BenchBudEE.kicad_pcb, BenchBudEE.sch]
2014-01-30 Created schematic hierarchy
    [Arduino.sch, BenchBudEE.sch, Fan.sch, LED_Driver.sch, Power.sch, Relay.sch, TerminalBlock.sch, Thermocouple.sch]
2014-02-03 Inputs/outputs added to hierarchical schematics
    [Arduino.sch, BenchBudEE.sch, Fan.sch, LED_Driver.sch, Relay.sch, Thermocouple.sch]
2014-02-03 Rough schematic created for thermocouple circuit
    [Thermocouple.sch]
2014-02-03 Rough schematic created for fan driver circuit
    [BenchBudEE.sch, Fan.sch]
2014-02-04 Added BenchBudEE.lib and symbol for SPDT relay
    [Arduino.sch, BenchBudEE.sch, Fan.sch, LED_Driver.sch, Power.sch, Relay.sch, TerminalBlock.sch, Thermocouple.sch]
2014-02-04 Rough schematic created for relay circuit
    [Relay.sch]
2014-02-04 -12P power symbol added
2014-02-04 Rough schematic created for power protection and filtering circuit
    [PowerAdjustmentMonitor.sch]
2014-02-04 Power protection and filtering sheet added to schematic
    [Arduino.sch, BenchBudEE.sch, Fan.sch, LED_Driver.sch, Power.sch, Relay.sch, TerminalBlock.sch, Thermocouple.sch]
2014-02-04 12volt net name fixed on relay schematic: use +12P instead of +12V
    [Relay.sch]
2014-02-05 Power protection and filtering circuit moved to Power.sch, was accidentally on PowerAdjustmentMonitor.sch
    [Power.sch, PowerAdjustmentMonitor.sch]
2014-02-05 Front-end V+ and V- power symbols added
2014-02-05 Rough schematic created for power control, conditioning and monitoring circuit
    [PowerAdjustmentMonitor.sch]
2014-02-05 Updated top level input/outputs
    [BenchBudEE.sch]
2014-02-05 Added symbol for AP5726 LED driver
2014-02-05 Rough schematic created for LED driver circuit
    [BenchBudEE.sch, LED_Driver.sch]
2014-02-12 Added Arduino and top-level connections
    [Arduino.sch, BenchBudEE.sch, Fan.sch, LED_Driver.sch, Relay.sch, TerminalBlock.sch]
2014-02-12 Current/fan driver circuit reworked
    [BenchBudEE.sch, Fan.sch, LED_Driver.sch, Power.sch]
2014-02-12 Some cleanup/fixes on the top-level
    [Arduino.sch, BenchBudEE.sch]
2014-02-16 Basic PCB setup done and changed some preferences
    [BenchBudEE.kicad_pcb]
2014-02-18 Added footprints for the relay module, preliminarily annotated schematic, relay components placed on PCB
    [Arduino.sch, BenchBudEE.kicad_pcb, BenchBudEE.sch, Fan.sch, LED_Driver.sch, Power.sch, PowerAdjustmentMonitor.sch, Relay.sch]
2014-02-19 Associated and placed the thermocouple module
    [Arduino.sch, BenchBudEE.kicad_pcb, BenchBudEE.sch, Fan.sch, PowerAdjustmentMonitor.sch, Thermocouple.sch]
2014-02-22 Associated and placed the terminal blocks and ATX header
    [BenchBudEE.kicad_pcb, Power.sch, TerminalBlock.sch]
2014-02-22 Associated and placed the Arduino
    [BenchBudEE.kicad_pcb]
2014-02-23 Associated and placed the Current/Fan Driver Module
    [Arduino.sch, BenchBudEE.kicad_pcb, BenchBudEE.sch, Fan.sch, Thermocouple.sch]
2014-02-23 Associated and placed the Power Filter Module
    [Arduino.sch, BenchBudEE.kicad_pcb, Fan.sch, Power.sch, PowerAdjustmentMonitor.sch, TerminalBlock.sch, Thermocouple.sch]
2014-02-23 Associated and placed the Power Modification Module
    [Arduino.sch, BenchBudEE.kicad_pcb, Fan.sch, PowerAdjustmentMonitor.sch, Thermocouple.sch]
2014-02-23 Associated and placed the LED Driver Module
    [Arduino.sch, BenchBudEE.kicad_pcb, Fan.sch, LED_Driver.sch, Power.sch, PowerAdjustmentMonitor.sch, Relay.sch, TerminalBlock.sch]
2014-02-23 Rearranged layout a bit and added heatsinks
    [BenchBudEE.kicad_pcb, BenchBudEE.sch]
2014-03-03 Various minor updates after Ground and Power Planes video
    [Arduino.sch, BenchBudEE.kicad_pcb, Fan.sch, LED_Driver.sch, Power.sch, PowerAdjustmentMonitor.sch, Relay.sch, TerminalBlock.sch]
2014-03-03 Updates from Reality Check video
    [Arduino.sch, BenchBudEE.kicad_pcb, BenchBudEE.sch, Fan.sch, LED_Driver.sch, Power.sch, PowerAdjustmentMonitor.sch, Relay.sch]
2014-03-03 Updates from Layout Work Session 2 video and KiCAD update
    [BenchBudEE.kicad_pcb]
2014-03-03 Updates from Layout Work Session 3 video
    [BenchBudEE.kicad_pcb]
2014-03-04 Updates from Layout Work Session 4 video
    [Arduino.sch, BenchBudEE.kicad_pcb, Fan.sch, LED_Driver.sch, PowerAdjustmentMonitor.sch, Relay.sch, TerminalBlock.sch, Thermocouple.sch]
2014-03-04 Updates from Layout Work Session 5 video
    [Arduino.sch, BenchBudEE.kicad_pcb, Fan.sch, Power.sch, PowerAdjustmentMonitor.sch, TerminalBlock.sch, Thermocouple.sch]
2014-03-04 Updates from Layout Work Session 6 video
    [Arduino.sch, BenchBudEE.kicad_pcb, Fan.sch, Power.sch, PowerAdjustmentMonitor.sch, TerminalBlock.sch, Thermocouple.sch]
2014-03-04 Updates from Layout Work Session 7 video
    [Arduino.sch, BenchBudEE.kicad_pcb, Fan.sch, LED_Driver.sch, Power.sch, PowerAdjustmentMonitor.sch, Relay.sch, TerminalBlock.sch]
2014-03-05 Updates from Connecting Ground Planes video
    [BenchBudEE.kicad_pcb]
2014-03-08 Relay layout
    [BenchBudEE.kicad_pcb]
2014-03-08 Power output layout
    [Arduino.sch, BenchBudEE.kicad_pcb, Fan.sch, LED_Driver.sch, Power.sch, PowerAdjustmentMonitor.sch, Relay.sch, TerminalBlock.sch]
2014-03-08 LED Module layout
    [BenchBudEE.kicad_pcb]
2014-03-11 Fan and TC module layout
    [Arduino.sch, BenchBudEE.kicad_pcb, Fan.sch, LED_Driver.sch, Power.sch, PowerAdjustmentMonitor.sch, Relay.sch, TerminalBlock.sch]
2014-03-11 Arduino layout
    [Arduino.sch, BenchBudEE.kicad_pcb, Fan.sch, LED_Driver.sch, Power.sch, PowerAdjustmentMonitor.sch, Relay.sch, TerminalBlock.sch]
2014-03-11 Connected remaing nets
    [Arduino.sch, BenchBudEE.kicad_pcb, Fan.sch, LED_Driver.sch, Power.sch, PowerAdjustmentMonitor.sch, Relay.sch, TerminalBlock.sch]
2014-03-12 Connected remaining ADC pins, some silk screen updates
    [Arduino.sch, BenchBudEE.kicad_pcb, Fan.sch, LED_Driver.sch, Power.sch, PowerAdjustmentMonitor.sch, Relay.sch, TerminalBlock.sch]
2014-03-12 More silk screen tweaks
    [BenchBudEE.kicad_pcb]
2014-03-12 More small tweaks (cf. Layout Work Session 16)
    [Arduino.sch, BenchBudEE.kicad_pcb, Fan.sch, LED_Driver.sch, Power.sch, PowerAdjustmentMonitor.sch, Relay.sch, TerminalBlock.sch]
2014-03-14 Test points added, silk screen updates
    [Arduino.sch, BenchBudEE.kicad_pcb, Fan.sch, LED_Driver.sch, Power.sch, PowerAdjustmentMonitor.sch, Relay.sch, TerminalBlock.sch]
2014-03-14 Added some R/C to analog sections
    [BenchBudEE.kicad_pcb, Fan.sch, PowerAdjustmentMonitor.sch, TerminalBlock.sch, Thermocouple.sch]
2014-03-15 Via annular ring size fixed
    [BenchBudEE.kicad_pcb]
2014-03-15 Ground point tweaked a bit
    [BenchBudEE.kicad_pcb]
2014-04-18 Assigned values to passives in Arduino, power adjustment monitor, relay and terminal block schematics
    [Arduino.sch, Power.sch, PowerAdjustmentMonitor.sch, Relay.sch, TerminalBlock.sch]
2014-04-18 BOM added
2014-04-18 BOM: found a replacement for the AP5726
2014-04-18 Assigned values to passives in fan and thermocouple schematics
    [Fan.sch, Thermocouple.sch]
2014-04-19 Back-annotated footprints into the schematic
    [Arduino.sch, Fan.sch, LED_Driver.sch, Power.sch, PowerAdjustmentMonitor.sch, Relay.sch, TerminalBlock.sch, Thermocouple.sch]
2014-04-19 BOM updated
2014-04-20 Final part numbers added to schematic, cross-checked KiCAD BOM against manual BOM
    [Arduino.sch, BenchBudEE.kicad_pcb, Fan.sch, LED_Driver.sch, Power.sch, PowerAdjustmentMonitor.sch, Relay.sch, TerminalBlock.sch]
2014-04-20 Tweak some quantities on the BOM, 100K and 1M resistors added
2014-04-21 Updated BOM for Farnell order
2014-04-21 Updated BOM for second Farnell order
